feverscreen/rpi-hat/README.md

# tko-rpi-hat
Raspberry Pi hat for the Te Kahu Ora cameras.
