feverscreen/rpi-hat/(commit log)

2020-07-30 Smaller PCB and use buck converter that JLCPCB can provide
    [fever-hat.csv, fever-hat.kicad_pcb, fever-hat.sch]
2020-07-31 Update unductor footprint
    [fever-hat.kicad_pcb, fever-hat.sch, fever-hat2.csv]
2020-08-11 tidy up
    [fever-hat.kicad_pcb]
2020-09-10 remove files that shouldn't be managed by git
    [fever-hat.csv, fever-hat2.csv]
2020-09-10 rename from fever-hat to tko-rpi-hat
    [tko-rpi-hat.kicad_pcb, tko-rpi-hat.sch]
2020-09-11 Few small chages to board layout to make plugs fit better
    [tko-rpi-hat.kicad_pcb, tko-rpi-hat.sch]
2020-09-28 Fix camera plug footprint
    [tko-rpi-hat.kicad_pcb, tko-rpi-hat.sch]
2020-11-11 Add gound connection to USB IC
    [tko-rpi-hat.kicad_pcb]
